daglem/reDIP-SID/hardware/reDIP-SID.kicad_pcb

## KiCad design hardware/reDIP-SID.kicad_pcb (2023-11-02)

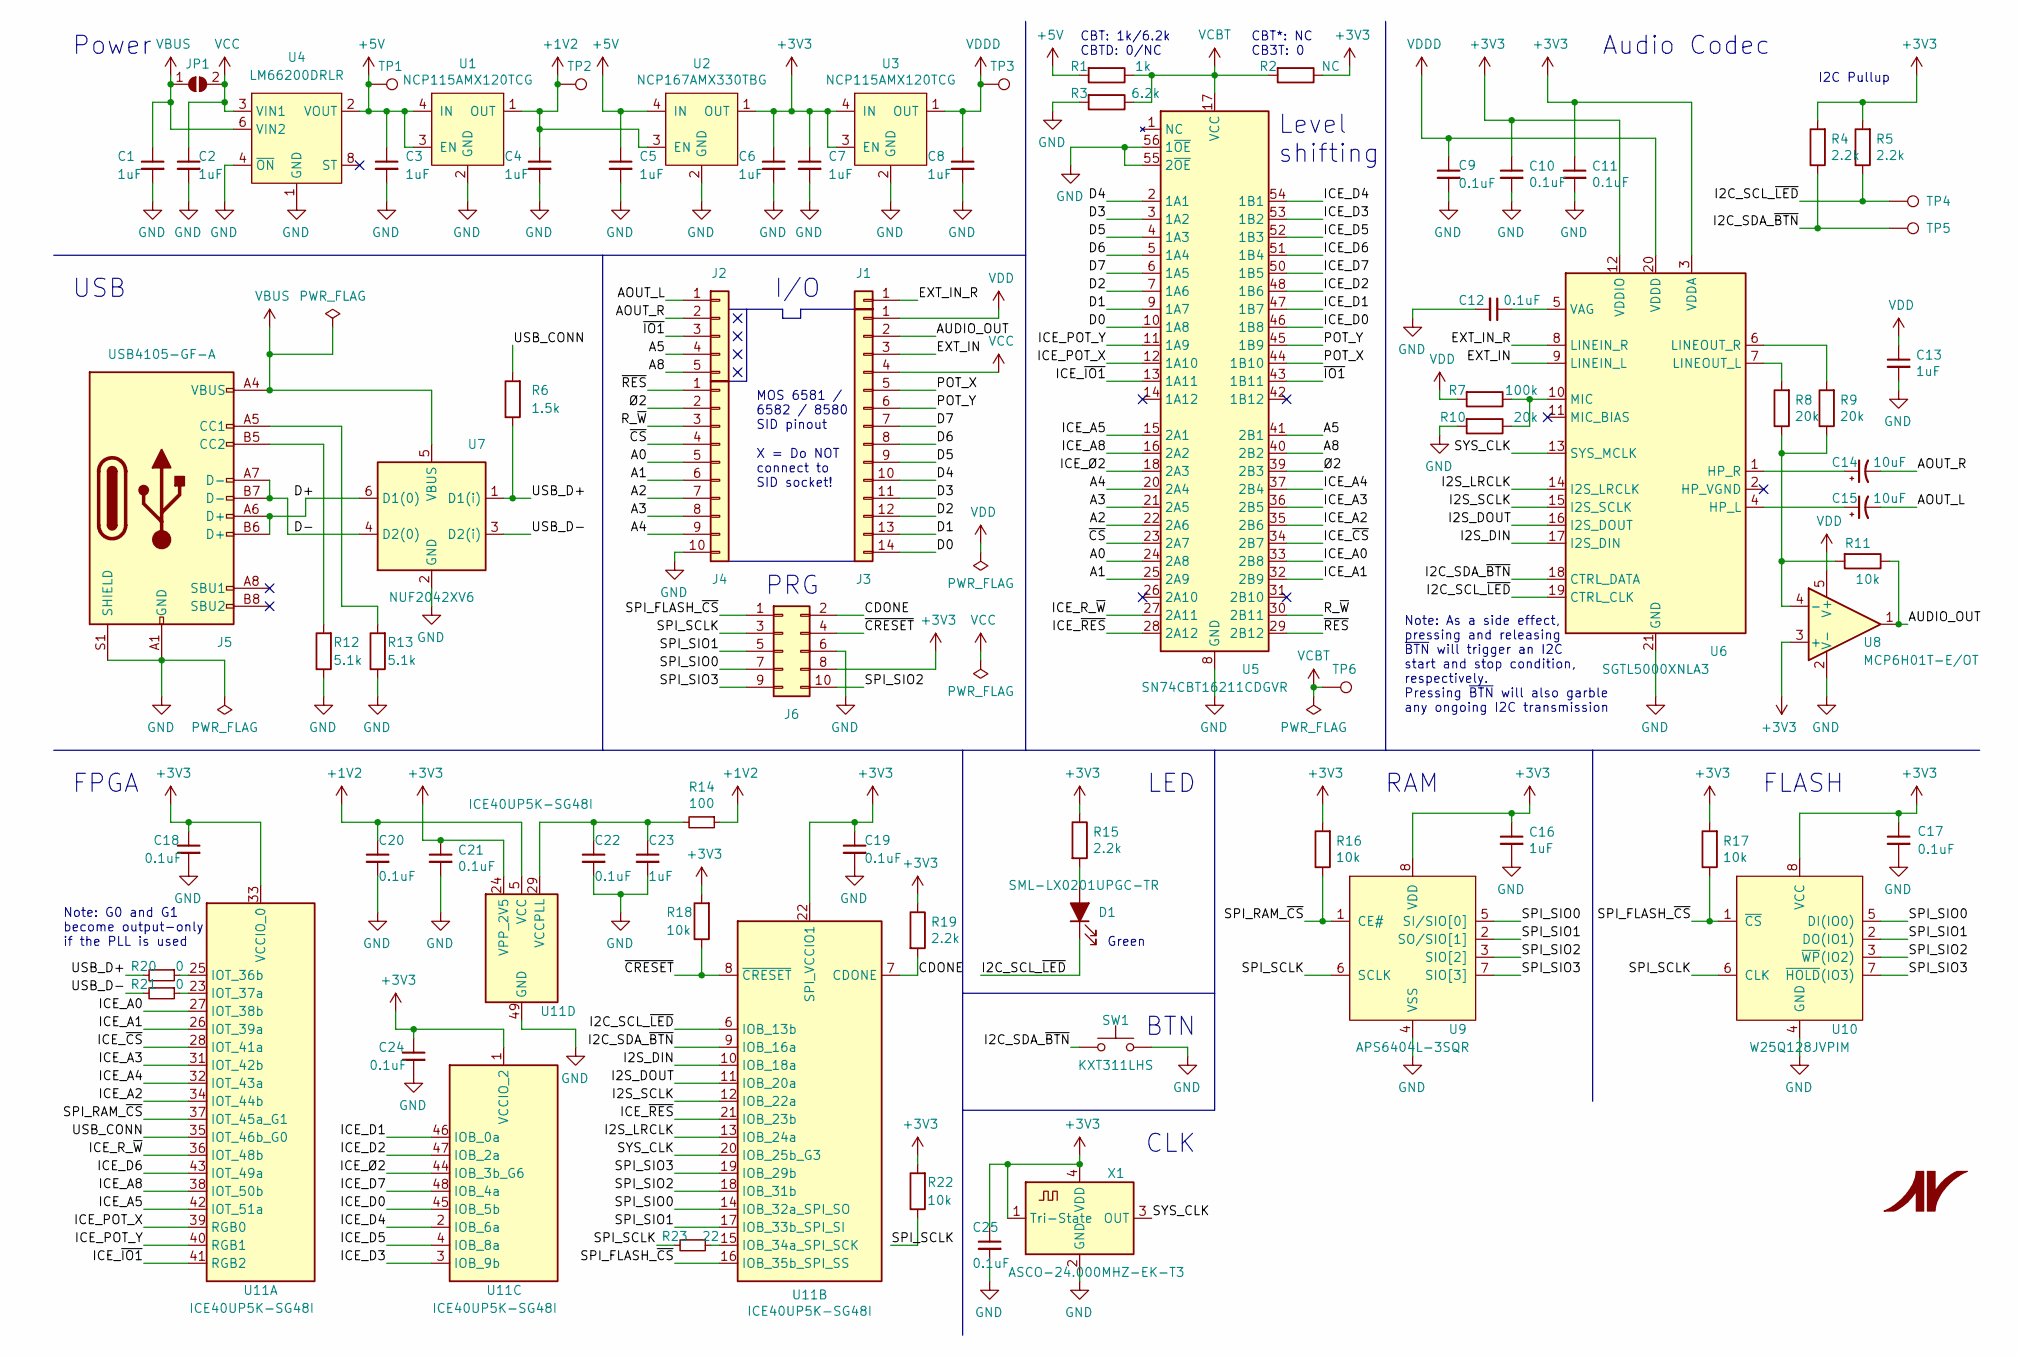
[picture p1: schematic reDIP-SID.kicad_sch, reDIP SID]

Parts:
C1, C2, C3, C5: 1uF; C_0402_1005Metric
C4, C6, C7, C8, C16, C23: 1uF; C_0201_0603Metric
C9, C10, C11, C12, C17, C18, C19, C20, C21, C22, C24, C25: 0.1uF; C_0201_0603Metric
C13: 1uF; C_0603_1608Metric
C14, C15: 10uF; CP_EIA-1608-08_AVX-J
D1: SML-LX0201UPGC-TR; SML-LX0201
J1: Conn_01x01; PinHeader_1x01_P2.54mm_Vertical
J2: Conn_01x05; PinHeader_1x05_P2.54mm_Vertical
J3: Conn_01x14; PinHeader_1x14_P2.54mm_Vertical_Machined
J4: Conn_01x10; PinHeader_1x10_P2.54mm_Vertical_Machined
J5: USB4105-GF-A; USB_C_Receptacle_HRO_TYPE-C-31-M-12
J6: Conn_02x05_Odd_Even; PinHeader_2x05_P2.54mm_Vertical
JP1: SolderJumper_2_Open; R_0402_1005Metric
R1: 1k; R_0201_0603Metric
R2: NC; R_0201_0603Metric
R3: 6.2k; R_0201_0603Metric
R4, R5, R15, R19: 2.2k; R_0201_0603Metric
R6: 1.5k; R_0201_0603Metric
R7: 100k; R_0201_0603Metric
R8, R9, R10: 20k; R_0201_0603Metric
R11, R16, R17, R18, R22: 10k; R_0201_0603Metric
R12, R13: 5.1k; R_0201_0603Metric
R14: 100; R_0201_0603Metric
R20, R21: 0; R_0201_0603Metric
R23: 22; R_0201_0603Metric
SW1: KXT311LHS; SW_SPST_CK_KXT3
TP1, TP2, TP3, TP4, TP5, TP6: TestPoint; TestPoint_Pad_D0.75mm
U1, U3: NCP115AMX120TCG; CASE_711AJ_1.0x1.0mm_P0.65mm
U2: NCP167AMX330TBG; CASE_711AJ_1.0x1.0mm_P0.65mm
U4: LM66200DRLR; SOT-5X3
U5: SN74CBT16211CDGVR; Texas_TVSOP-56_4.4x11.3mm_P0.4mm
U6: SGTL5000XNLA3; QFN-20-1EP_3x3mm_P0.4mm_EP1.65x1.65mm
U7: NUF2042XV6; SOT-563
U8: MCP6H01T-E/OT; SOT-23-5
U9: APS6404L-3SQR; SOP-8_3.9x4.9mm_P1.27mm
U10: W25Q128JVPIM; WSON-8-1EP_6x5mm_P1.27mm_EP3.4x4.3mm
U11: ICE40UP5K-SG48I; QFN-48-1EP_7x7mm_P0.5mm_EP5.6x5.6mm
X1: ASCO-24.000MHZ-EK-T3; Oscillator_SMD-4Pin_1.6x1.2mm

Connections:
+1V2: C4.1, C20.1, R14.1, TP2.1, U1.1 (OUT), U2.3 (EN), U11.5 (VCC), U11.30 (VCC)
+3V3: C6.1, C7.1, C10.1, C11.1, C16.1, C17.1, C18.1, C19.1, C21.1, C24.1, C25.1, J6.8, R2.1, R4.2, R5.2, R15.1, R16.2, R17.2, R18.2, R19.1, R22.2, U2.1 (OUT), U3.3 (EN), U3.4 (IN), U6.3 (VDDA), U6.12 (VDDIO), U8.3 (+), U9.8 (VDD), U10.8 (VCC), U11.1 (VCCIO_2), U11.22 (SPI_VCCIO1), U11.24 (VPP_2V5), U11.33 (VCCIO_0), X1.1 (Tri-State), X1.4 (VDD)
+5V: C3.1, C5.1, R1.2, TP1.1, U1.3 (EN), U1.4 (IN), U2.4 (IN), U4.2 (VOUT), U4.7 (VOUT)
/A0: J4.5, U5.24 (2A8)
/A1: J4.6, U5.25 (2A9)
/A2: J4.7, U5.22 (2A6)
/A3: J4.8, U5.21 (2A5)
/A4: J4.9, U5.20 (2A4)
/A5: J2.4, U5.41 (2B1)
/A8: J2.5, U5.40 (2B2)
/AOUT_L: C15.2, J2.1
/AOUT_R: C14.2, J2.2
/AUDIO_OUT: J3.2, R11.1, U8.1
/CDONE: J6.2, R19.2, U11.7 (CDONE)
/D0: J3.14, U5.10 (1A8)
/D1: J3.13, U5.9 (1A7)
/D2: J3.12, U5.7 (1A6)
/D3: J3.11, U5.3 (1A2)
/D4: J3.10, U5.2 (1A1)
/D5: J3.9, U5.4 (1A3)
/D6: J3.8, U5.5 (1A4)
/D7: J3.7, U5.6 (1A5)
/D+: J5.A6 (D+), J5.B6 (D+), U7.6 (D1(0))
/D-: J5.A7 (D-), J5.B7 (D-), U7.4 (D2(0))
/EXT_IN: J3.3, U6.9 (LINEIN_L)
/EXT_IN_R: J1.1, U6.8 (LINEIN_R)
/I2C_SCL_~LED: D1.1 (K), R5.1, TP4.1, U6.19 (CTRL_CLK), U11.6 (IOB_13b)
/I2C_SDA_~BTN: R4.1, SW1.1, TP5.1, U6.18 (CTRL_DATA), U11.9 (IOB_16a)
/I2S_DIN: U6.17 (I2S_DIN), U11.10 (IOB_18a)
/I2S_DOUT: U6.16 (I2S_DOUT), U11.11 (IOB_20a)
/I2S_LRCLK: U6.14 (I2S_LRCLK), U11.13 (IOB_24a)
/I2S_SCLK: U6.15 (I2S_SCLK), U11.12 (IOB_22a)
/ICE_A0: U5.33 (2B8), U11.27 (IOT_38b)
/ICE_A1: U5.32 (2B9), U11.26 (IOT_39a)
/ICE_A2: U5.35 (2B6), U11.34 (IOT_44b)
/ICE_A3: U5.36 (2B5), U11.31 (IOT_42b)
/ICE_A4: U5.37 (2B4), U11.32 (IOT_43a)
/ICE_A5: U5.15 (2A1), U11.42 (IOT_51a)
/ICE_A8: U5.16 (2A2), U11.38 (IOT_50b)
/ICE_D0: U5.46 (1B8), U11.45 (IOB_5b)
/ICE_D1: U5.47 (1B7), U11.46 (IOB_0a)
/ICE_D2: U5.48 (1B6), U11.47 (IOB_2a)
/ICE_D3: U5.53 (1B2), U11.3 (IOB_9b)
/ICE_D4: U5.54 (1B1), U11.2 (IOB_6a)
/ICE_D5: U5.52 (1B3), U11.4 (IOB_8a)
/ICE_D6: U5.51 (1B4), U11.43 (IOT_49a)
/ICE_D7: U5.50 (1B5), U11.48 (IOB_4a)
/ICE_POT_X: U5.12 (1A10), U11.39 (RGB0)
/ICE_POT_Y: U5.11 (1A9), U11.40 (RGB1)
/ICE_R_~W: U5.27 (2A11), U11.36 (IOT_48b)
/ICE_~CS: U5.34 (2B7), U11.28 (IOT_41a)
/ICE_~IO1: U5.13 (1A11), U11.41 (RGB2)
/ICE_~RES: U5.28 (2A12), U11.21 (IOB_23b)
/ICE_Ø2: U5.18 (2A3), U11.44 (IOB_3b_G6)
/POT_X: J3.5, U5.44 (1B10)
/POT_Y: J3.6, U5.45 (1B9)
/R_~W: J4.3, U5.30 (2B11)
/SPI_FLASH_~CS: J6.1, R17.1, U10.1 (~CS), U11.16 (IOB_35b_SPI_SS)
/SPI_RAM_~CS: R16.1, U9.1 (CE#), U11.37 (IOT_45a_G1)
/SPI_SCLK: J6.3, R22.1, R23.2, U9.6 (SCLK), U10.6 (CLK)
/SPI_SIO0: J6.7, U9.5 (SI/SIO[0]), U10.5 (DI(IO0)), U11.14 (IOB_32a_SPI_SO)
/SPI_SIO1: J6.5, U9.2 (SO/SIO[1]), U10.2 (DO(IO1)), U11.17 (IOB_33b_SPI_SI)
/SPI_SIO2: J6.10, U9.3 (SIO[2]), U10.3 (~WP(IO2)), U11.18 (IOB_31b)
/SPI_SIO3: J6.9, U9.7 (SIO[3]), U10.7 (~HOLD(IO3)), U11.19 (IOB_29b)
/SYS_CLK: U6.13 (SYS_MCLK), U11.20 (IOB_25b_G3), X1.3 (OUT)
/USB_CONN: R6.2, U11.35 (IOT_46b_G0)
/USB_D+: R6.1, R20.2, U7.1 (D1(i))
/USB_D-: R21.2, U7.3 (D2(i))
/~CRESET: J6.4, R18.1, U11.8 (~CRESET)
/~CS: J4.4, U5.23 (2A7)
/~IO1: J2.3, U5.43 (1B11)
/~RES: J4.1, U5.29 (2B12)
/Ø2: J4.2, U5.39 (2B3)
GND: C1.2, C2.2, C3.2, C4.2, C5.2, C6.2, C7.2, C8.2, C9.2, C10.2, C11.2, C12.2, C13.2, C16.2, C17.2, C18.2, C19.2, C20.2, C21.2, C22.2, C23.2, C24.2, C25.2, J4.10, J5.A1 (GND), J5.A12 (GND), J5.B1 (GND), J5.B12 (GND), J5.S1 (SHIELD), J6.6, R3.2, R10.2, R12.1, R13.1, SW1.2, U1.2 (GND), U2.2 (GND), U3.2 (GND), U4.1 (GND), U4.4 (~ON), U4.5 (GND), U5.8 (GND), U5.19 (GND), U5.38 (GND), U5.49 (GND), U5.55 (2~OE), U5.56 (1~OE), U6.21 (GND), U7.2 (GND), U8.2 (V-), U9.4 (VSS), U10.4 (GND), U10.9 (GND), U11.49 (GND), X1.2 (GND)
unnamed: D1.2 (A), R15.2
unnamed: J5.A5 (CC1), R13.2
unnamed: J5.B5 (CC2), R12.2
unnamed: C15.1, U6.4 (HP_L)
unnamed: C14.1, U6.1 (HP_R)
unnamed: R8.2, U6.7 (LINEOUT_L)
unnamed: R9.2, U6.6 (LINEOUT_R)
unnamed: R7.1, R10.1, U6.10 (MIC)
unnamed: C12.1, U6.5 (VAG)
unnamed: R8.1, R9.1, R11.2, U8.4 (-)
unnamed: R20.1, U11.25 (IOT_36b)
unnamed: R21.1, U11.23 (IOT_37a)
unnamed: R23.1, U11.15 (IOB_34a_SPI_SCK)
unnamed: C22.1, C23.1, R14.2, U11.29 (VCCPLL)
VBUS: C1.1, J5.A4 (VBUS), J5.A9 (VBUS), J5.B4 (VBUS), J5.B9 (VBUS), JP1.1 (A), U4.6 (VIN2), U7.5 (VBUS)
VCBT: R1.1, R2.2, R3.1, TP6.1, U5.17 (VCC)
VCC: C2.1, J3.4, JP1.2 (B), U4.3 (VIN1)
VDD: C13.1, J3.1, R7.2, U8.5 (V+)
VDDD: C8.1, C9.1, TP3.1, U3.1 (OUT), U6.20 (VDDD)

Notes on the sheet:
MOS 6581 / 6582 / 8580 SID pinout X = Do NOT connect to SID socket!
Note: As a side effect, pressing and releasing ~{BTN} will trigger an I2C start and stop condition, respectively. Pressing ~{BTN} will also garble any ongoing I2C transmission
PRG
FLASH
FPGA
USB
RAM
CLK
Power
Green
CBT*: NC CB3T: 0
BTN
LED
I/O
Level shifting
Audio Codec
CBT: 1k/6.2k CBTD: 0/NC
Note: G0 and G1 become output-only if the PLL is used
I2C Pullup

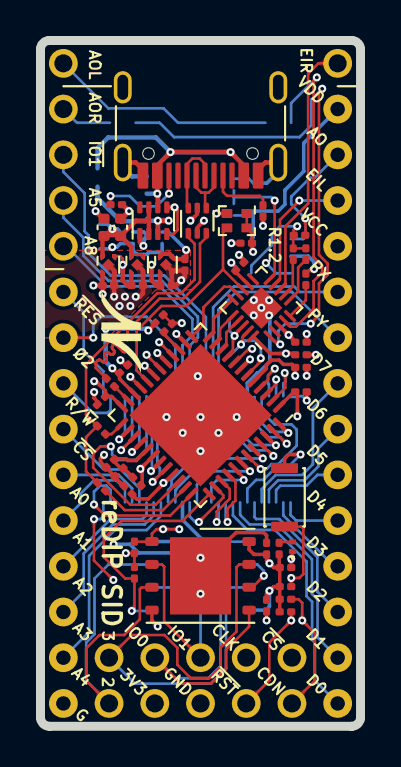
[picture p2: board reDIP-SID.kicad_pcb from above]

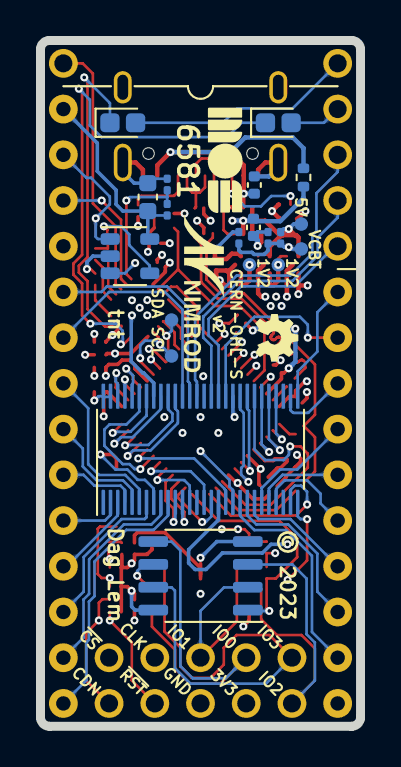
[picture p3: board reDIP-SID.kicad_pcb from below]

Board: 4 copper layers, 17.8 x 38.1 mm, 100 parts (42 on the bottom side), 93 nets.

Other parts of the board:
MOS logo: G***; MOS-logo
SolderMask_D0.5mm, SolderMask_D0.5mm#2, SolderMask_D0.5mm#3, SolderMask_D0.5mm#4, SolderMask_D0.5mm#5: SolderMask_D0.5mm
SolderMask_D0.25mm, SolderMask_D0.25mm#2, SolderMask_D0.25mm#3, SolderMask_D0.25mm#4, SolderMask_D0.25mm#5, SolderMask_D0.25mm#6, SolderMask_D0.25mm#7, SolderMask_D0.25mm#8, SolderMask_D0.25mm#9, SolderMask_D0.25mm#10, SolderMask_D0.25mm#11, SolderMask_D0.25mm#12, SolderMask_D0.25mm#13, SolderMask_D0.25mm#14, SolderMask_D0.25mm#15, SolderMask_D0.25mm#16, SolderMask_D0.25mm#17, SolderMask_D0.25mm#18, SolderMask_D0.25mm#19: SolderMask_D0.25mm
