daglem/reDIP-SID/(notices)

Notices in the files:
hardware/reDIP-SID.kicad_pcb:
© 2021-2023 Dag Lem
Licensed under CERN-OHL-S v2 (https://ohwr.org/cern_ohl_s_v2.txt)
© 2023
CERN-OHL-S
